AosorP/DP-trolling-motor/MEGA SHIELD SCHMATICS AND PHOTOS/DP-TROLLING MEGA SHIELD BOTOM SIDE.jpg

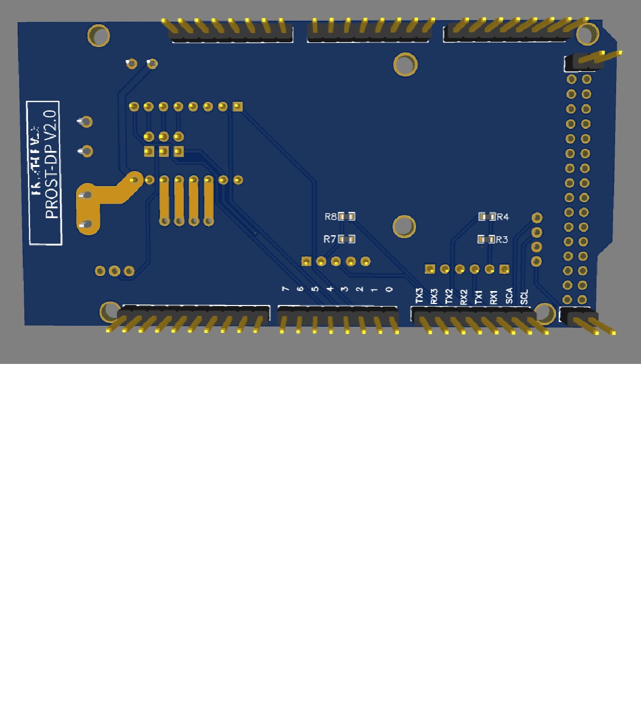
MEGA SHIELD SCHMATICS AND PHOTOS/DP-TROLLING MEGA SHIELD BOTOM SIDE.jpg
