AosorP/DP-trolling-motor/MEGA SHIELD SCHMATICS AND PHOTOS/DP-TROLLING MEGA SHIELD TOP SIDE.jpg

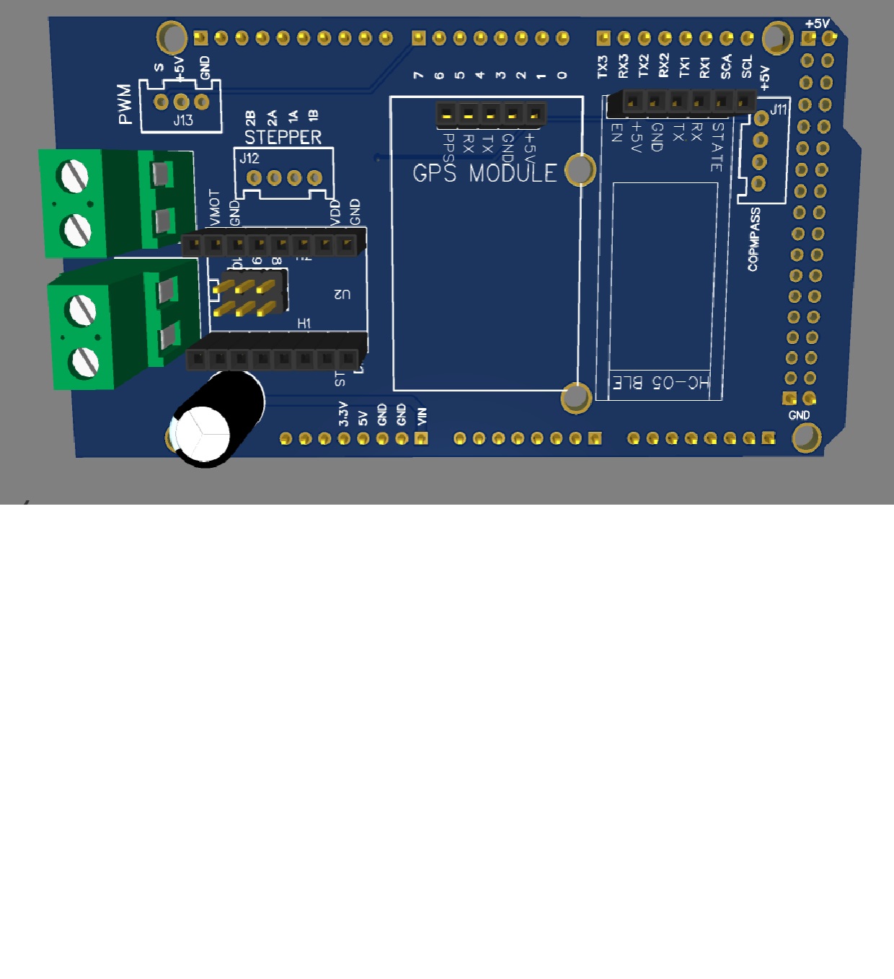
MEGA SHIELD SCHMATICS AND PHOTOS/DP-TROLLING MEGA SHIELD TOP SIDE.jpg
