AosorP/DP-trolling-motor/MEGA SHIELD SCHMATICS AND PHOTOS/Schematic_DP-SHIELD-ARDUINO-MEGA.pdf

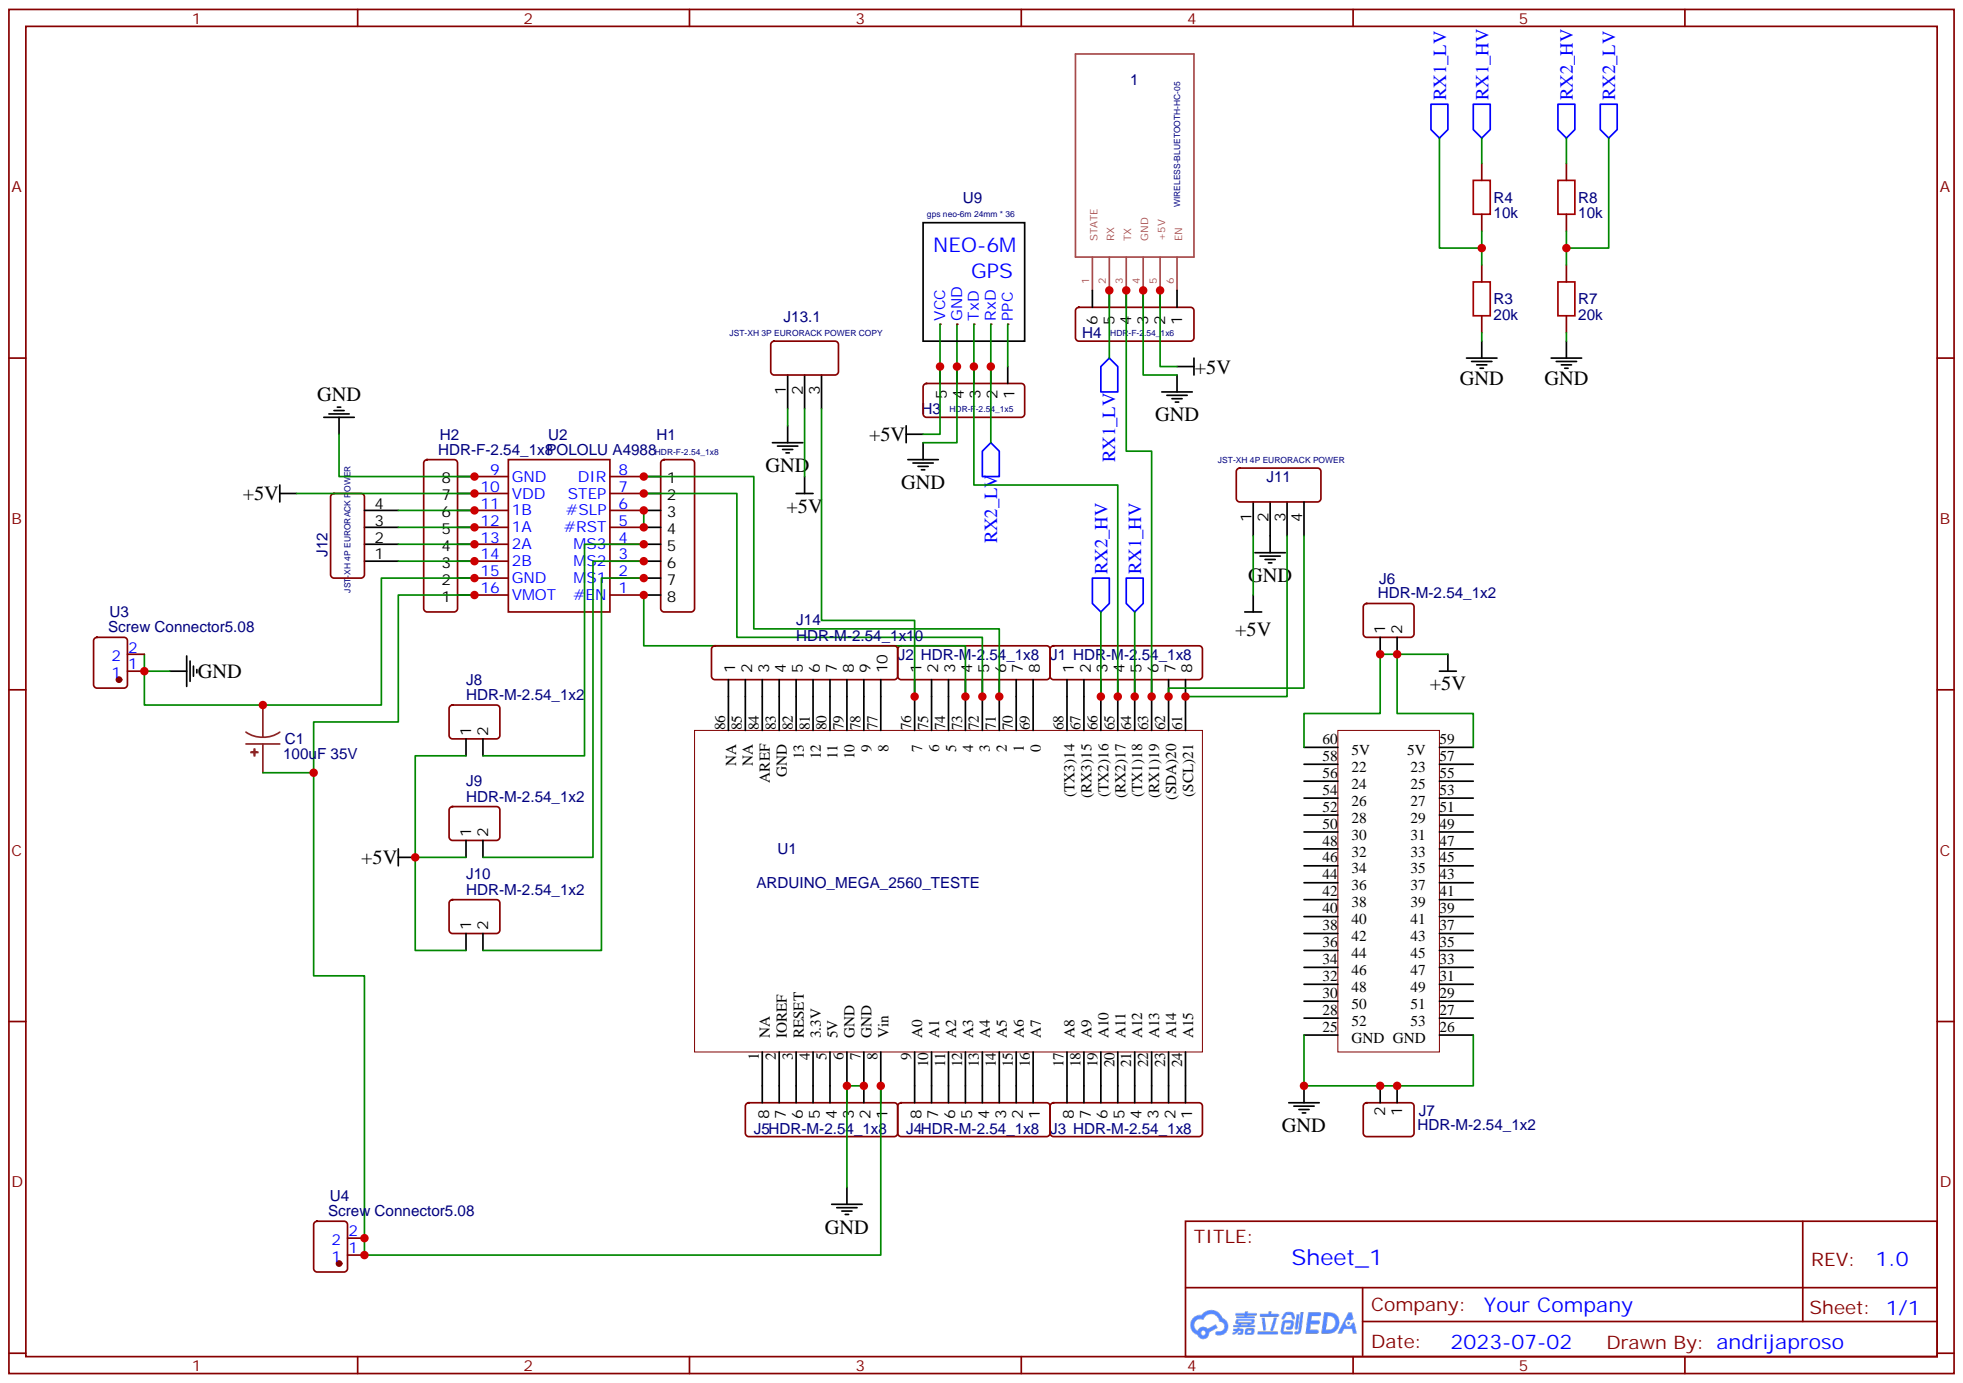
[picture p3: page 1]

JST-XH 3P EURORACK POWER COPY

JST-XH 4P EURORACK POWER
